FaulknerMassimo/rPod/src/input/wheel_input.c

#include "wheel_input.h"

#include "wheel_tuning.h"
#include "../../daemon/wheel_protocol.h"

#include <errno.h>
#include <stdbool.h>
#include <stdio.h>
#include <stdlib.h>
#include <string.h>
#include <sys/socket.h>
#include <sys/un.h>
#include <unistd.h>

#define POLL_MS       10
#define RETRY_MS      1000

/* --- scroll acceleration (docs/PLAN.md §8.2) -----------------------------
 *
 * Wheel speed is measured over a sliding window of recent wheel events, using
 * the daemon's own timestamps (when the packet came off the wire, not when
 * this poll got to it). Below V0 every STEP_TICKS positions is one step, for
 * precise slow scrolling; between V0 and V1 the multiplier eases in
 * quadratically up to ACCEL_MAX, so a fast flick covers many rows. The
 * numbers are input/wheel_tuning.h's, read on every event so they can be
 * tuned while the wheel turns. */
#define VEL_WINDOW_US       150000u
#define VEL_MIN_SPAN_US     20000u
#define VEL_RING            64

/* --- alphabet scrub (docs/PLAN.md §8.2) -----------------------------------
 *
 * In a long alphabetical list, turning faster than SCRUB_V switches from rows
 * to letters (ui/scrub.h): the list's current letter shows big, and from
 * then on every SCRUB_TICKS positions -- at any speed, so it can be slowed
 * down to land on a letter -- jumps a whole letter. It ends when the finger
 * lifts or the wheel rests for SCRUB_IDLE_MS. SCRUB_V defaults to V1, where
 * the acceleration curve tops out: a list long enough to have letters
 * hands over to them there instead. */
#define SCRUB_IDLE_MS       600u

typedef struct {
    /* Recent wheel events inside the velocity window: ring of (time, |delta|). */
    struct {
        uint64_t ts;
        int ticks;
    } win[VEL_RING];
    int win_head;   /* index of the oldest entry */
    int win_count;
    int win_sum;    /* sum of ticks over the entries in the ring */

    float acc;      /* gain-scaled positions not yet turned into whole steps */
    int last_dir;
    float speed;    /* positions/s as of the last event */
} accel_t;

/* A new gesture (touch down/up, reversal) starts from rest: no leftover
 * fraction of a step, no speed carried over from before. */
static void accel_reset(accel_t *a)
{
    a->win_head = 0;
    a->win_count = 0;
    a->win_sum = 0;
    a->acc = 0.0f;
    a->last_dir = 0;
    a->speed = 0.0f;
}

/* Feeds one wheel delta; returns the whole steps it produced (signed). */
static int accel_feed(accel_t *a, int delta, uint64_t ts)
{
    if (delta == 0) {
        return 0;
    }
    int dir = delta > 0 ? 1 : -1;
    if (a->last_dir != 0 && dir != a->last_dir) {
        accel_reset(a);
    }
    a->last_dir = dir;

    /* Expire events that fell out of the window, then add this one (evicting
     * the oldest if the ring is full -- that only underestimates speed). */
    while (a->win_count > 0 && ts - a->win[a->win_head].ts > VEL_WINDOW_US) {
        a->win_sum -= a->win[a->win_head].ticks;
        a->win_head = (a->win_head + 1) % VEL_RING;
        a->win_count--;
    }
    if (a->win_count == VEL_RING) {
        a->win_sum -= a->win[a->win_head].ticks;
        a->win_head = (a->win_head + 1) % VEL_RING;
        a->win_count--;
    }
    int slot = (a->win_head + a->win_count) % VEL_RING;
    a->win[slot].ts = ts;
    a->win[slot].ticks = abs(delta);
    a->win_count++;
    a->win_sum += abs(delta);

    /* Speed over the span the window actually covers, not the whole window:
     * a flick is often shorter than VEL_WINDOW_US, and dividing by the full
     * window would keep acceleration from engaging until it was nearly over.
     * The oldest event's ticks were travelled before the span began, so they
     * don't count; MIN_SPAN keeps two packets arriving close together from
     * reading as a huge spike. A lone event reads as speed 0. */
    int oldest = a->win_head;
    int newest = (a->win_head + a->win_count - 1) % VEL_RING;
    uint64_t span = a->win[newest].ts - a->win[oldest].ts;
    if (span < VEL_MIN_SPAN_US) {
        span = VEL_MIN_SPAN_US;
    }
    float speed = (float)(a->win_sum - a->win[oldest].ticks) * 1e6f / (float)span;
    a->speed = speed;
    const rpod_wheel_tuning_t *tu = rpod_wheel_tuning();
    float v1 = tu->accel_v1 > tu->accel_v0 ? tu->accel_v1 : tu->accel_v0 + 1.0f;
    float t = (speed - tu->accel_v0) / (v1 - tu->accel_v0);
    t = t < 0.0f ? 0.0f : (t > 1.0f ? 1.0f : t);
    float gain = 1.0f + (tu->accel_max - 1.0f) * t * t;

    a->acc += (float)delta * gain;
    int steps = (int)(a->acc / tu->step_ticks); /* truncates toward zero */
    a->acc -= (float)steps * tu->step_ticks;
    return steps;
}

typedef struct {
    bool active;
    float acc;       /* positions toward the next letter */
    int dir;
    uint32_t last_ms; /* lv_tick_get() of the last wheel event while active */
} scrub_t;

/* --- socket client --------------------------------------------------------- */

typedef struct {
    rpod_input_t *in;
    char path[sizeof(((struct sockaddr_un *)0)->sun_path)];

    int fd;                 /* -1 while disconnected */
    uint32_t retry_at;      /* lv_tick_get() time of the next connect attempt */
    bool logged_waiting;

    /* SOCK_STREAM can split an event across reads; carry partial bytes over. */
    uint8_t rx[sizeof(struct rpod_wheel_event) * 32];
    size_t rx_len;

    accel_t accel;
    scrub_t scrub;
} wheel_input_t;

static void try_connect(wheel_input_t *w)
{
    int fd = socket(AF_UNIX, SOCK_STREAM | SOCK_NONBLOCK | SOCK_CLOEXEC, 0);
    if (fd < 0) {
        return;
    }
    struct sockaddr_un addr;
    memset(&addr, 0, sizeof(addr));
    addr.sun_family = AF_UNIX;
    memcpy(addr.sun_path, w->path, sizeof(addr.sun_path));

    if (connect(fd, (struct sockaddr *)&addr, sizeof(addr)) != 0) {
        close(fd);
        if (!w->logged_waiting) {
            fprintf(stderr, "rpod: waiting for the click wheel daemon at %s\n", w->path);
            w->logged_waiting = true;
        }
        return;
    }
    fprintf(stderr, "rpod: click wheel connected (%s)\n", w->path);
    w->fd = fd;
    w->rx_len = 0;
    w->logged_waiting = false;
}

/* Back to rows, from rest -- the next turn doesn't inherit the scrub's speed. */
static void scrub_end(wheel_input_t *w)
{
    if (w->scrub.active) {
        w->scrub.active = false;
        accel_reset(&w->accel);
    }
}

/* Drops the connection and lets go of anything held, so a daemon restart
 * mid-press can't leave the select button stuck down -- without that
 * synthetic release counting as a click. */
static void disconnect(wheel_input_t *w)
{
    fprintf(stderr, "rpod: click wheel daemon went away; reconnecting\n");
    close(w->fd);
    w->fd = -1;
    w->retry_at = lv_tick_get() + RETRY_MS;
    rpod_input_release_all(w->in);
    scrub_end(w);
    accel_reset(&w->accel);
}

/* One wheel event while scrubbing: a letter per SCRUB_TICKS positions. A
 * reversal starts the count over, so the first letter back isn't early. */
static void scrub_feed(wheel_input_t *w, int delta)
{
    int dir = delta > 0 ? 1 : -1;
    if (dir != w->scrub.dir) {
        w->scrub.dir = dir;
        w->scrub.acc = 0.0f;
    }
    w->scrub.last_ms = lv_tick_get();
    w->scrub.acc += (float)abs(delta);
    float ticks = rpod_wheel_tuning()->scrub_ticks;
    while (w->scrub.acc >= ticks) {
        w->scrub.acc -= ticks;
        if (!rpod_input_scrub(w->in, dir)) {
            scrub_end(w); /* the screen changed under it */
            return;
        }
    }
}

static void handle_wheel(wheel_input_t *w, const struct rpod_wheel_event *ev)
{
    if (rpod_input_fine()) {
        rpod_input_rotate(w->in, ev->value); /* a game steering: position for position */
        return;
    }
    if (w->scrub.active) {
        scrub_feed(w, ev->value);
        return;
    }
    int steps = accel_feed(&w->accel, ev->value, ev->timestamp_us);
    if (w->accel.speed >= rpod_wheel_tuning_scrub_v() && rpod_input_scrub(w->in, 0)) {
        w->scrub.active = true;
        w->scrub.dir = 0;
        w->scrub.last_ms = lv_tick_get();
        return; /* this turn just brings up the letter */
    }
    rpod_input_rotate(w->in, steps);
}

static void handle_event(wheel_input_t *w, const struct rpod_wheel_event *ev)
{
    static const rpod_button_t k_buttons[] = {
        [RPOD_WHEEL_BTN_CENTER] = RPOD_BTN_CENTER,
        [RPOD_WHEEL_BTN_UP]     = RPOD_BTN_MENU,
        [RPOD_WHEEL_BTN_DOWN]   = RPOD_BTN_PLAY_PAUSE,
        [RPOD_WHEEL_BTN_LEFT]   = RPOD_BTN_PREV,
        [RPOD_WHEEL_BTN_RIGHT]  = RPOD_BTN_NEXT,
    };

    switch (ev->type) {
    case RPOD_WHEEL_EVENT_WHEEL:
        handle_wheel(w, ev);
        break;

    case RPOD_WHEEL_EVENT_TOUCH:
        if (ev->value == 0) {
            scrub_end(w);
        } else {
            rpod_input_touch(w->in);
        }
        accel_reset(&w->accel);
        break;

    case RPOD_WHEEL_EVENT_BUTTON:
        if (ev->code >= sizeof(k_buttons) / sizeof(k_buttons[0])) {
            break;
        }
        if (ev->value != 0) {
            scrub_end(w);
        }
        /* Fed per edge, not once per poll: a tap whose press and release
         * land in the same poll must still register. */
        rpod_input_button(w->in, k_buttons[ev->code], ev->value != 0);
        break;

    default:
        break;
    }
}

static void poll_cb(lv_timer_t *timer)
{
    wheel_input_t *w = lv_timer_get_user_data(timer);

    if (w->fd < 0) {
        if ((int32_t)(lv_tick_get() - w->retry_at) < 0) {
            return;
        }
        try_connect(w);
        if (w->fd < 0) {
            w->retry_at = lv_tick_get() + RETRY_MS;
            return;
        }
    }

    bool got_any = false;
    for (;;) {
        ssize_t n = recv(w->fd, w->rx + w->rx_len, sizeof(w->rx) - w->rx_len, MSG_DONTWAIT);
        if (n < 0 && (errno == EAGAIN || errno == EWOULDBLOCK)) {
            break;
        }
        if (n < 0 && errno == EINTR) {
            continue;
        }
        if (n <= 0) {
            disconnect(w);
            break;
        }
        w->rx_len += (size_t)n;

        size_t off = 0;
        while (w->rx_len - off >= sizeof(struct rpod_wheel_event)) {
            struct rpod_wheel_event ev;
            memcpy(&ev, w->rx + off, sizeof(ev));
            off += sizeof(ev);
            handle_event(w, &ev);
            got_any = true;
        }
        memmove(w->rx, w->rx + off, w->rx_len - off);
        w->rx_len -= off;
    }

    if (w->scrub.active && lv_tick_elaps(w->scrub.last_ms) > SCRUB_IDLE_MS) {
        scrub_end(w);
    }

    /* Hand it to LVGL now rather than waiting up to a whole read period for
     * the indev's own timer -- a button should feel instant. */
    if (got_any) {
        lv_indev_read(rpod_input_indev(w->in));
    }
}

void rpod_wheel_input_create(const char *sock_path, rpod_input_t *in)
{
    wheel_input_t *w = calloc(1, sizeof(*w));
    w->in = in;
    snprintf(w->path, sizeof(w->path), "%s", sock_path != NULL ? sock_path : RPOD_WHEEL_SOCK_PATH);
    w->fd = -1;
    w->retry_at = lv_tick_get();

    const rpod_wheel_tuning_t *tu = rpod_wheel_tuning();
    fprintf(stderr, "rpod: wheel accel: %.1f positions/step, x%.1f max between %.0f and %.0f positions/s\n",
            (double)tu->step_ticks, (double)tu->accel_max, (double)tu->accel_v0, (double)tu->accel_v1);
    fprintf(stderr, "rpod: wheel scrub: letters above %.0f positions/s, %.1f positions/letter\n",
            (double)rpod_wheel_tuning_scrub_v(), (double)tu->scrub_ticks);

    lv_timer_create(poll_cb, POLL_MS, w);
}
