FaulknerMassimo/rPod/src/ui/screens/music_screens.c

#include "music_screens.h"

#include "list_screen.h"
#include "now_playing.h"
#include "search_screen.h"
#include "playlist_edit_screens.h"
#include "playlist_picker.h"
#include "audio/mpd_client.h"
#include "ui/alpha_sort.h"
#include "ui/classic.h"
#include "ui/cover_cache.h"
#include "ui/heart_icon.h"
#include "ui/metrics.h"
#include "ui/playlist_membership.h"
#include "ui/scrub.h"
#include "ui/theme.h"

#include <stdint.h>
#include <stdio.h>
#include <stdlib.h>
#include <string.h>

/* Per-screen filter, passed as the rpod_screen_stack_push() ctx for every
 * browse/leaf screen below. Which fields are meaningful depends on the
 * screen: album/artist lists use `artist`; the song list uses whichever of
 * `artist`+`album` or `playlist` got set on the way down. */
typedef struct {
    rpod_mpd_t *mpd;
    char *artist;
    char *album;
    char *genre;
    char *playlist;
} music_ctx_t;

static char *dup_or_null(const char *s)
{
    return s != NULL ? strdup(s) : NULL;
}

static music_ctx_t *music_ctx_new(rpod_mpd_t *mpd, const char *artist, const char *album,
                                   const char *genre, const char *playlist)
{
    music_ctx_t *ctx = calloc(1, sizeof(*ctx));
    ctx->mpd = mpd;
    ctx->artist = dup_or_null(artist);
    ctx->album = dup_or_null(album);
    ctx->genre = dup_or_null(genre);
    ctx->playlist = dup_or_null(playlist);
    return ctx;
}

static void music_ctx_free(void *p)
{
    music_ctx_t *ctx = p;
    free(ctx->artist);
    free(ctx->album);
    free(ctx->genre);
    free(ctx->playlist);
    free(ctx);
}

/* A clicked row's context for the name-only browse screens (artists,
 * albums, genres, playlists): which connection, which name, and -- for
 * albums reached via an artist -- which artist scoped the list, so
 * selecting an album can carry the artist filter forward to the song list. */
typedef struct {
    rpod_mpd_t *mpd;
    const char *name;
    const char *parent_artist;
} name_row_t;

/* Owns the raw mpd_item_t array a browse screen fetched plus the name_row_t
 * array built from it, both freed together when the screen is popped. */
typedef struct {
    rpod_mpd_item_t *items_raw;
    name_row_t *rows;
} name_list_fetch_t;

static void name_list_cleanup_cb(lv_event_t *e)
{
    name_list_fetch_t *fetch = lv_event_get_user_data(e);
    rpod_mpd_free_items(fetch->items_raw);
    free(fetch->rows);
    free(fetch);
}

static int item_alpha_cmp(const void *a, const void *b)
{
    return rpod_alpha_compare(((const rpod_mpd_item_t *)a)->name, ((const rpod_mpd_item_t *)b)->name);
}

/* Shared plumbing for every name-only browse screen: takes ownership of
 * `items_raw` (already fetched by the caller), builds the on-screen list,
 * and wires each row's item_ctx to a name_row_t carrying `parent_artist`
 * through (NULL where it doesn't apply).
 *
 * Rows go in iPod order (ui/alpha_sort.h) rather than MPD's: its `list` is a
 * plain byte sort, which puts lowercase names after every capitalised one
 * and accented ones after Z -- and the alphabet scrub needs each letter's
 * rows together. */
static void build_name_list_screen(rpod_screen_stack_t *stack, lv_obj_t *screen,
                                    rpod_mpd_t *mpd, rpod_mpd_item_t *items_raw, size_t count,
                                    const char *parent_artist,
                                    void (*on_select)(rpod_screen_stack_t *, void *))
{
    if (count > 1) {
        qsort(items_raw, count, sizeof(*items_raw), item_alpha_cmp);
    }

    name_list_fetch_t *fetch = malloc(sizeof(*fetch));
    fetch->items_raw = items_raw;
    fetch->rows = count > 0 ? malloc(count * sizeof(*fetch->rows)) : NULL;
    for (size_t i = 0; i < count; i++) {
        fetch->rows[i].mpd = mpd;
        fetch->rows[i].name = items_raw[i].name;
        fetch->rows[i].parent_artist = parent_artist;
    }
    lv_obj_add_event_cb(screen, name_list_cleanup_cb, LV_EVENT_DELETE, fetch);

    rpod_list_item_t *ui_items = count > 0 ? calloc(count, sizeof(*ui_items)) : NULL;
    for (size_t i = 0; i < count; i++) {
        snprintf(ui_items[i].text, sizeof(ui_items[i].text), "%s", items_raw[i].name);
        ui_items[i].chevron = true;
        ui_items[i].on_select = on_select;
        ui_items[i].item_ctx = &fetch->rows[i];
    }
    lv_obj_t *list = rpod_list_screen_build(stack, screen, ui_items, count);
    rpod_list_screen_enable_scrub(screen, list);
    free(ui_items);
}

static void build_song_list_screen(rpod_screen_stack_t *stack, lv_obj_t *screen, void *ctx);
static void build_album_list_screen(rpod_screen_stack_t *stack, lv_obj_t *screen, void *ctx);
static void build_genre_artist_list_screen(rpod_screen_stack_t *stack, lv_obj_t *screen, void *ctx);
static rpod_row_status_t status_for_uri(const rpod_playlist_index_t *idx, const char *uri);

static void on_album_select(rpod_screen_stack_t *stack, void *item_ctx)
{
    name_row_t *row = item_ctx;
    rpod_screen_stack_push(stack, build_song_list_screen,
                            music_ctx_new(row->mpd, row->parent_artist, row->name, NULL, NULL),
                            music_ctx_free);
}

static void on_artist_select(rpod_screen_stack_t *stack, void *item_ctx)
{
    name_row_t *row = item_ctx;
    rpod_screen_stack_push(stack, build_album_list_screen,
                            music_ctx_new(row->mpd, row->name, NULL, NULL, NULL),
                            music_ctx_free);
}

static void on_genre_select(rpod_screen_stack_t *stack, void *item_ctx)
{
    name_row_t *row = item_ctx;
    rpod_screen_stack_push(stack, build_genre_artist_list_screen,
                            music_ctx_new(row->mpd, NULL, NULL, row->name, NULL), music_ctx_free);
}

static void on_playlist_select(rpod_screen_stack_t *stack, void *item_ctx)
{
    name_row_t *row = item_ctx;
    rpod_screen_stack_push(stack, build_song_list_screen,
                            music_ctx_new(row->mpd, NULL, NULL, NULL, row->name), music_ctx_free);
}

static void build_album_list_screen(rpod_screen_stack_t *stack, lv_obj_t *screen, void *ctx)
{
    music_ctx_t *filter = ctx;
    if (filter->artist != NULL) {
        rpod_screen_stack_set_title(stack, filter->artist);
    }
    rpod_mpd_item_t *items = NULL;
    size_t count = 0;
    rpod_mpd_list_albums(filter->mpd, filter->artist, &items, &count);
    build_name_list_screen(stack, screen, filter->mpd, items, count, filter->artist, on_album_select);
}

static void build_artist_list_screen(rpod_screen_stack_t *stack, lv_obj_t *screen, void *ctx)
{
    music_ctx_t *filter = ctx;
    rpod_mpd_item_t *items = NULL;
    size_t count = 0;
    rpod_mpd_list_artists(filter->mpd, &items, &count);
    build_name_list_screen(stack, screen, filter->mpd, items, count, NULL, on_artist_select);
}

static void build_genre_artist_list_screen(rpod_screen_stack_t *stack, lv_obj_t *screen, void *ctx)
{
    music_ctx_t *filter = ctx;
    rpod_screen_stack_set_title(stack, filter->genre);
    rpod_mpd_item_t *items = NULL;
    size_t count = 0;
    rpod_mpd_list_artists_in_genre(filter->mpd, filter->genre, &items, &count);
    /* Same next screen as the plain Artists list: pick an artist, browse
     * their albums -- the genre filter has done its job by here. */
    build_name_list_screen(stack, screen, filter->mpd, items, count, NULL, on_artist_select);
}

static void build_genre_list_screen(rpod_screen_stack_t *stack, lv_obj_t *screen, void *ctx)
{
    music_ctx_t *filter = ctx;
    rpod_mpd_item_t *items = NULL;
    size_t count = 0;
    rpod_mpd_list_genres(filter->mpd, &items, &count);
    build_name_list_screen(stack, screen, filter->mpd, items, count, NULL, on_genre_select);
}

static void on_new_playlist(rpod_screen_stack_t *stack, void *item_ctx)
{
    rpod_screen_stack_push(stack, rpod_new_playlist_name_build, item_ctx, NULL);
}

/* Not routed through build_name_list_screen -- that helper assumes a 1:1
 * mapping between fetched items and rows, but this list also needs one
 * extra leading action row ("New Playlist") that isn't an MPD playlist at
 * all.
 *
 * Rebuilds (rather than being built once): a brand new playlist only
 * starts existing server-side once its first song is added, from the Add
 * Songs picker pushed on top of this screen -- so this screen's own rows,
 * fetched back when it was first pushed, would otherwise go stale the
 * moment the user backs out and never show the playlist they just made.
 * Called directly for the initial build and again from
 * playlist_list_loaded_cb on every LV_EVENT_SCREEN_LOADED (i.e. every time
 * this screen becomes visible again, including via pop -- see
 * screen_stack.c's pop() for why group-default ordering makes it safe for
 * a LOADED handler to create fresh focusable rows here). */
static void populate_playlist_list(rpod_screen_stack_t *stack, lv_obj_t *screen, rpod_mpd_t *mpd)
{
    lv_obj_t *old_list = lv_obj_get_child(screen, 0);
    if (old_list != NULL) {
        lv_obj_delete(old_list);
    }

    rpod_mpd_item_t *items = NULL;
    size_t count = 0;
    rpod_mpd_list_playlists(mpd, &items, &count);

    name_list_fetch_t *fetch = malloc(sizeof(*fetch));
    fetch->items_raw = items;
    /* One extra row slot for the pinned "Liked Songs" entry (row index
     * `count`), whose name is a stable string literal rather than an
     * items_raw[] pointer. */
    fetch->rows = malloc((count + 1) * sizeof(*fetch->rows));
    for (size_t i = 0; i < count; i++) {
        fetch->rows[i].mpd = mpd;
        fetch->rows[i].name = items[i].name;
        fetch->rows[i].parent_artist = NULL;
    }
    fetch->rows[count].mpd = mpd;
    fetch->rows[count].name = RPOD_LIKED_PLAYLIST_NAME;
    fetch->rows[count].parent_artist = NULL;

    /* Leading rows: "New Playlist", then "Liked Songs" pinned above the rest
     * (shown even before it exists server-side). A real "Liked Songs" among
     * the fetched playlists is skipped below so it isn't listed twice. */
    rpod_list_item_t *ui_items = calloc(count + 2, sizeof(*ui_items));
    size_t ui = 0;
    snprintf(ui_items[ui].text, sizeof(ui_items[ui].text), "New Playlist");
    ui_items[ui].chevron = true;
    ui_items[ui].on_select = on_new_playlist;
    ui_items[ui].item_ctx = mpd;
    ui++;
    snprintf(ui_items[ui].text, sizeof(ui_items[ui].text), "%s", RPOD_LIKED_PLAYLIST_NAME);
    ui_items[ui].chevron = true;
    ui_items[ui].on_select = on_playlist_select;
    ui_items[ui].item_ctx = &fetch->rows[count];
    ui++;
    for (size_t i = 0; i < count; i++) {
        if (strcmp(items[i].name, RPOD_LIKED_PLAYLIST_NAME) == 0) {
            continue;
        }
        snprintf(ui_items[ui].text, sizeof(ui_items[ui].text), "%s", items[i].name);
        ui_items[ui].chevron = true;
        ui_items[ui].on_select = on_playlist_select;
        ui_items[ui].item_ctx = &fetch->rows[i];
        ui++;
    }
    rpod_list_screen_build(stack, screen, ui_items, ui);
    free(ui_items);

    /* Attached to the freshly created list itself, not the screen -- so
     * the lv_obj_delete(old_list) above on the *next* refresh frees this
     * exact fetch at the right time instead of leaking it until the whole
     * screen is torn down. */
    lv_obj_t *list = lv_obj_get_child(screen, 0);
    lv_obj_add_event_cb(list, name_list_cleanup_cb, LV_EVENT_DELETE, fetch);
}

typedef struct {
    rpod_screen_stack_t *stack;
    rpod_mpd_t *mpd;
} playlists_screen_ctx_t;

static void playlists_screen_ctx_free_cb(lv_event_t *e)
{
    free(lv_event_get_user_data(e));
}

static void playlist_list_loaded_cb(lv_event_t *e)
{
    playlists_screen_ctx_t *pc = lv_event_get_user_data(e);
    populate_playlist_list(pc->stack, lv_event_get_target(e), pc->mpd);
}

static void build_playlist_list_screen(rpod_screen_stack_t *stack, lv_obj_t *screen, void *ctx)
{
    music_ctx_t *filter = ctx;

    playlists_screen_ctx_t *pc = malloc(sizeof(*pc));
    pc->stack = stack;
    pc->mpd = filter->mpd;
    lv_obj_add_event_cb(screen, playlist_list_loaded_cb, LV_EVENT_SCREEN_LOADED, pc);
    lv_obj_add_event_cb(screen, playlists_screen_ctx_free_cb, LV_EVENT_DELETE, pc);
}

/* A clicked song row's context: the connection, plus the whole fetched song
 * collection this row belongs to (owned by the fetch) and this row's index
 * within it. Selecting a row queues the entire collection and starts at
 * `index`, so playback carries on through the album/playlist rather than
 * stopping after the one tapped track. */
typedef struct {
    rpod_mpd_t *mpd;
    const rpod_mpd_song_t *songs;
    size_t count;
    size_t index;
} song_row_t;

typedef struct {
    rpod_mpd_t *mpd;
    rpod_screen_stack_t *stack;
    rpod_mpd_song_t *songs;
    size_t count;
    song_row_t *rows;
    bool show_art; /* rows carry a cover column (see build_song_list_screen) */
    /* The collection header's cover tile (build_collection_header() below)
     * and the songs whose album covers it shows: one for a single album, up
     * to four distinct albums as a 2x2 mosaic for a playlist. Covers decode in
     * the background (ui/cover_cache.h); refresh_header_cover() fills the tile
     * once they've all resolved. header_tile is NULL for lists with no header
     * (artist song lists). */
    lv_obj_t *header_tile;
    size_t header_cover_songs[4];
    size_t header_cover_count;
    bool header_filled;

    /* Liked/playlist indicators. The index is (re)built and the rows'
     * trailing marks refreshed whenever the screen regains focus (see
     * song_list_loaded_cb), so a like made on Now Playing or an edit made in
     * the Add-to-Playlist picker shows on return. `list`, `lead`, and
     * `header_present` locate the song rows among the list's children. */
    rpod_playlist_index_t *index;
    lv_obj_t *list;
    size_t lead;
    bool header_present;
} song_list_fetch_t;

static void song_list_cleanup_cb(lv_event_t *e)
{
    song_list_fetch_t *fetch = lv_event_get_user_data(e);
    rpod_playlist_index_free(fetch->index);
    rpod_mpd_free_songs(fetch->songs);
    free(fetch->rows);
    free(fetch);
}

/* On (re)gaining focus: refresh the playlist index and every song row's mark.
 * Built here rather than at build time so the first focus and every return
 * share one path -- see the same pattern in build_playlist_list_screen. */
static void song_list_loaded_cb(lv_event_t *e)
{
    song_list_fetch_t *fetch = lv_event_get_user_data(e);
    if (fetch->index == NULL) {
        fetch->index = rpod_playlist_index_build(fetch->mpd);
    } else {
        rpod_playlist_index_rebuild(fetch->index, fetch->mpd);
    }

    size_t base = (fetch->header_present ? 1 : 0) + fetch->lead;
    for (size_t j = 0; j < fetch->count; j++) {
        lv_obj_t *btn = lv_obj_get_child(fetch->list, (int32_t)(base + j));
        if (btn == NULL) {
            break;
        }
        rpod_list_row_set_status(btn, status_for_uri(fetch->index, fetch->songs[j].uri));
    }
}

static void on_song_select(rpod_screen_stack_t *stack, void *item_ctx)
{
    song_row_t *row = item_ctx;
    rpod_mpd_play_songs_from(row->mpd, row->songs, row->count, row->index);
    rpod_screen_stack_push(stack, rpod_now_playing_build, row->mpd, NULL);
}

/* Press-and-hold a song row: open the Add-to-Playlist picker for it. */
static void on_song_long_press(rpod_screen_stack_t *stack, void *item_ctx)
{
    song_row_t *row = item_ctx;
    const rpod_mpd_song_t *s = &row->songs[row->index];
    rpod_playlist_picker_push(stack, row->mpd, s->uri, s->title);
}

/* Heart for a liked song, checkmark for one in some other playlist, else
 * nothing -- the heart wins when a song is both liked and in a playlist. */
static rpod_row_status_t status_for_uri(const rpod_playlist_index_t *idx, const char *uri)
{
    if (rpod_playlist_index_is_liked(idx, uri)) {
        return RPOD_ROW_STATUS_HEART;
    }
    if (rpod_playlist_index_in_other(idx, uri)) {
        return RPOD_ROW_STATUS_CHECK;
    }
    return RPOD_ROW_STATUS_NONE;
}

static void on_add_songs_to_playlist(rpod_screen_stack_t *stack, void *item_ctx)
{
    music_ctx_t *filter = item_ctx;
    rpod_push_add_songs_screen(stack, filter->mpd, filter->playlist);
}

/* Square size (px) the collection header's cover tile renders at -- bigger
 * than a row thumbnail (rpod_metrics()->list_art_size), smaller than Now
 * Playing's ART_SIZE, since it shares the screen with the title/subtitle, the
 * Play/Shuffle row, and the rows below -- all of which need to fit inside
 * the list's own viewport height (screen_h - header_h - 16, see
 * rpod_list_screen_create()) for Play/Shuffle to be visible without scrolling
 * on first load. A playlist's 2x2 mosaic splits this tile into four
 * RPOD_HEADER_ART_SIZE/2 quadrants. */
#define RPOD_HEADER_ART_SIZE 72

static void on_play_collection_clicked(lv_event_t *e)
{
    song_list_fetch_t *fetch = lv_event_get_user_data(e);
    if (fetch->count == 0) {
        return;
    }
    rpod_mpd_play_songs(fetch->mpd, fetch->songs, fetch->count);
    rpod_screen_stack_push(fetch->stack, rpod_now_playing_build, fetch->mpd, NULL);
}

static void on_shuffle_collection_clicked(lv_event_t *e)
{
    song_list_fetch_t *fetch = lv_event_get_user_data(e);
    if (fetch->count == 0) {
        return;
    }
    rpod_mpd_play_songs_shuffled(fetch->mpd, fetch->songs, fetch->count);
    rpod_screen_stack_push(fetch->stack, rpod_now_playing_build, fetch->mpd, NULL);
}

/* Play/Shuffle sit at the *bottom* of the header, below the cover and
 * title/subtitle -- LVGL's own scroll-on-focus (or row_focus_cb's pattern for
 * plain rows) only scrolls far enough to reveal the focused object itself,
 * so re-focusing Play/Shuffle after scrolling down into the song list would
 * otherwise leave just the button row in view with the cover scrolled past
 * the top edge. Scroll the whole header (btn's grandparent: btn -> btn_row
 * -> header) into view instead, so the cover comes back with it. */
static void collection_header_button_focused_cb(lv_event_t *e)
{
    lv_obj_t *btn = lv_event_get_target(e);
    /* Classic's rows are the header's own children; scrolling to the row
     * itself is all they need. */
    if (rpod_theme()->classic) {
        lv_obj_scroll_to_view_recursive(btn, LV_ANIM_OFF);
        return;
    }
    lv_obj_t *header = lv_obj_get_parent(lv_obj_get_parent(btn));
    lv_obj_scroll_to_view_recursive(header, LV_ANIM_OFF);
}

static lv_obj_t *build_collection_action_button(lv_obj_t *parent, const char *label,
                                                lv_event_cb_t on_click, song_list_fetch_t *fetch)
{
    lv_obj_t *btn = lv_button_create(parent);
    lv_obj_remove_style_all(btn);
    /* See row_focus_cb in list_screen.c: LVGL's default eased scroll-on-focus
     * reads as laggy against a click wheel, and here it would also fight
     * with collection_header_button_focused_cb's own scroll target. */
    lv_obj_remove_flag(btn, LV_OBJ_FLAG_SCROLL_ON_FOCUS);
    const rpod_metrics_t *m = rpod_metrics();
    lv_obj_set_size(btn, (m->screen_w - 16 - 2 * 14 - 12) / 2, 36);
    lv_obj_set_style_radius(btn, 8, 0);
    lv_obj_set_style_bg_color(btn, RPOD_COLOR_GLASS_FILL, LV_STATE_DEFAULT);
    lv_obj_set_style_bg_opa(btn, LV_OPA_COVER, LV_STATE_DEFAULT);
    lv_obj_set_style_bg_color(btn, RPOD_COLOR_ACCENT, LV_STATE_FOCUSED);
    lv_obj_set_style_bg_opa(btn, LV_OPA_COVER, LV_STATE_FOCUSED);

    lv_obj_t *lbl = lv_label_create(btn);
    lv_label_set_text(lbl, label);
    lv_obj_set_style_text_color(lbl, RPOD_COLOR_TEXT, 0);
    lv_obj_center(lbl);

    lv_obj_add_event_cb(btn, on_click, LV_EVENT_CLICKED, fetch);
    lv_obj_add_event_cb(btn, collection_header_button_focused_cb, LV_EVENT_FOCUSED, NULL);
    return btn;
}

/* Fills the header's cover tile once every requested cover has resolved:
 * a single cover fills the whole tile (a plain album), two-to-four lay out
 * as a 2x2 mosaic (a playlist collage), each cover one quadrant. Fewer than
 * four decoded covers cycle to fill all four quadrants -- a half-blank
 * mosaic reads as broken, a repeated tile reads as intentional. Nothing
 * decodable keeps the audio-symbol placeholder, same as a row with no art.
 * Waits for all of them rather than drawing progressively, so a mosaic
 * doesn't visibly reshuffle as each cover lands. Each cover is requested at
 * its on-screen size (full tile vs. quadrant), per list_screen.h's note
 * against leaning on lv_image to rescale. Called at build time (covers may
 * already be cached) and again as background decodes finish. */
static void refresh_header_cover(song_list_fetch_t *fetch)
{
    if (fetch->header_tile == NULL || fetch->header_filled) {
        return;
    }
    bool mosaic = fetch->header_cover_count > 1;
    int cell = mosaic ? RPOD_HEADER_ART_SIZE / 2 : RPOD_HEADER_ART_SIZE;

    const lv_image_dsc_t *ready[4];
    size_t k = 0;
    for (size_t i = 0; i < fetch->header_cover_count; i++) {
        const rpod_mpd_song_t *s = &fetch->songs[fetch->header_cover_songs[i]];
        bool pending = false;
        const lv_image_dsc_t *dsc = rpod_cover_cache_get(s->album_artist, s->album, s->uri, cell, &pending);
        if (pending) {
            return;
        }
        if (dsc != NULL) {
            ready[k++] = dsc;
        }
    }
    fetch->header_filled = true;
    if (k == 0) {
        return;
    }

    lv_obj_t *tile = fetch->header_tile;
    lv_obj_clean(tile);
    if (!mosaic) {
        lv_obj_t *img = lv_image_create(tile);
        lv_image_set_src(img, ready[0]);
        lv_obj_set_size(img, RPOD_HEADER_ART_SIZE, RPOD_HEADER_ART_SIZE);
        lv_obj_center(img);
    } else {
        for (int q = 0; q < 4; q++) {
            lv_obj_t *img = lv_image_create(tile);
            lv_image_set_src(img, ready[q % (int)k]);
            lv_obj_set_size(img, cell, cell);
            lv_obj_set_pos(img, (q % 2) * cell, (q / 2) * cell);
        }
    }
}
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
