FaulknerMassimo/rPod/(commit log)

2026-07-20 Scaffold Phase 0: repo layout, sim harness, cross-build, wheel sniffer
    Sets up the structure from docs/PLAN.md: LVGL v9.5.0 vendored as a submodule,
    a desktop SDL simulator for UI iteration without hardware, a cross-compiled
    hello-world entry point, systemd units, boot config fragments, and
    tools/wheel-sniff.c to derive the real click-wheel bit map on real hardware
    before any parsing code is written.
2026-07-20 Phase 1: LVGL on the fbtft framebuffer
    Adds src/ui/lvgl_port.c to bind LVGL to /dev/fb1 via the Linux fbdev
    driver, and a device-side lv_conf.h configured per docs/PLAN.md §5.3
    (partial rendering, two 40-line draw buffers). main.c now renders the
    same "rPod" label + spinner scene as the desktop simulator instead of
    the Phase 0 hello-world stub, so both are directly comparable.
    tools/fb-test.c is a dependency-free raw-framebuffer colour-fill tool
    for the §5.2/§9 bring-up step (confirm orientation/offsets/colour
    order) independently of LVGL, isolating panel wiring bugs from UI
    bugs. Both sim and device lv_conf.h now enable the on-screen perf
    monitor so fps is visible for the Phase 1 accept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
    [fb-test.c, lvgl_port.c, lvgl_port.h, main.c]
2026-07-20 Phase 2: click wheel decoder daemon and test client
    Adds daemon/rpod-wheel.c: a privileged root process that decodes the
    4th-gen click wheel's synchronous serial stream (docs/PLAN.md §4.2,
    same framing algorithm as tools/wheel-sniff.c) and publishes edge-
    triggered button events, wrap-corrected wheel deltas, and touch state
    over a Unix socket at /run/rpod/wheel.sock. Handles the hold switch
    (suppress emission, keep decoding) and haptics (runtime-tunable pulse
    divisor via SIGHUP + /etc/rpod/wheel.conf).
    The wire struct and socket path live in daemon/wheel_protocol.h, which
    has no hardware dependency and builds immediately. The actual field
    bit positions live in daemon/wheel_bits.h, split ou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
    [rpod-wheel.c, wheel-test-client.c, wheel_bits.h, wheel_protocol.h]
2026-07-20 Add docs/wiring.md with physical header pin numbers
    docs/PLAN.md §1.2 only lists BCM GPIO numbers, which isn't enough to
    place a wire on the 40-pin header. Adds the physical pin for every
    signal, plus a callout for the GPIO 25 collision between the display's
    D/C line (Waveshare's default wiring) and the click wheel's DATA line
    (fixed to match the sPot reference schematic) — the project already
    wires around it via dc_pin=24 in system/config.txt.d/rpod.txt, but
    it's an easy trap to fall into wiring from the panel's own docs.
2026-07-20 Phase 1: fix landscape orientation and two hardware-verified display bugs
    Corrects docs/PLAN.md's screen orientation: click-wheel iPods (4th gen,
    Photo, Video/Classic, Mini) had landscape screens above the wheel, despite
    the device body being portrait overall. §5/§8 and the fbtft overlay
    (rotate=90 added, dc_pin unaffected) now reflect that; sim and device
    configs both switch to 320x240.
    Two real bugs found and fixed by testing on actual hardware:
    - LV_MEM_SIZE (64K) was too tight for the wider landscape draw buffers,
    and LV_USE_ASSERT_MALLOC's handler turns a failed allocation into a
    silent infinite-loop hang: 100% CPU, no crash, no log output, screen
    just never updates. Bumped to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
2026-07-20 Fix pigpio init failure on vc4-kms-v3d (initMboxBlock: mbox zaps failed)
    gpioInitialise() failed outright on real hardware with dtoverlay=vc4-kms-v3d
    active (system/config.txt.d/rpod.txt) — the DRM/KMS driver holds the legacy
    GPU memory pool that pigpio's default mailbox-based DMA allocation needs,
    independent of gpu_mem=. Calling gpioCfgMemAlloc(PI_MEM_ALLOC_PAGEMAP)
    before gpioInitialise() sidesteps the mailbox path entirely and fixes it.
    Confirmed on hardware in both tools/wheel-sniff.c and daemon/rpod-wheel.c.
    Also notes in docs/PLAN.md that pigpio isn't packaged for this OS (only
    the pigpiod_if2 daemon-client split is available via apt) — build the
    classic library from source direc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
    [rpod-wheel.c, wheel-sniff.c]
2026-07-21 UI: full screen graph in the simulator, backed by real local MPD
    The click wheel is dead and the DAC isn't wired up, so this pulls forward
    the UI-integration parts of Phase 4 that don't depend on either: the full
    Main Menu / Music browse+playback / Now Playing / Settings / Extras screen
    graph (src/ui/screens/), a libmpdclient wrapper (src/audio/mpd_client.c),
    and a keyboard-as-wheel stand-in for the simulator (tools/sim/sim_input.c).
    Also fixes four bugs found by testing against a real MPD instance and a
    real 552-track library rather than mocked data: libmpdclient's searchadd
    side effect enqueuing tracks just from browsing, a connection error that
    wasn't being cleared and silently broke eve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
    [list_screen.c, list_screen.h, main_menu.c, main_menu.h, music_screens.c, music_screens.h]
2026-07-21 UI: iOS-style Now Playing screen with real cover art
    Redesigns Now Playing with a rounded cover-art tile, title/artist/album
    typographic hierarchy, and a thin scrubber with elapsed/remaining time --
    no transport buttons, since the click wheel already drives playback
    globally regardless of which screen is on top.
    Cover art is fetched via MPD's readpicture/albumart and decoded with a
    memory-conscious pipeline built for this project's 512 MB budget: JPEG
    via TJpgDec, point-sampled straight down to thumbnail size as MCU blocks
    stream in so the full-resolution image is never materialized; PNG via a
    small decoder of our own against system zlib, since this project's
    vendored lodepng.c is an LVGL f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
    [cover_art.c, cover_art.h, now_playing.c]
2026-07-21 UI: iOS-style menu rows with song metadata
    List rows now render as an iOS-style inset card list: dark elevated row
    background, separators between rows, optional dim subtitle line, optional
    right-aligned accessory text, and an optional ">" chevron for rows that
    push another screen. Song rows show "Artist - Album" plus duration;
    Audio Output rows show On/Off as an accessory instead of jammed into the
    title.
    Fixes along the way, found via a headless lv_snapshot_take() render
    rather than the real app:
    - Row titles were invisible against the new dark row background because
    the light-mode theme's default text color was never overridden.
    - Long titles/subtitles wrapped instead of truncating -- L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
    [list_screen.c, list_screen.h, main_menu.c, music_screens.c, settings_screens.c, theme.h]
2026-07-21 UI: liquid glass styling and an audio-reactive Now Playing visualizer
    Applies a translucent "glass" material (theme.c/h:
    rpod_theme_style_glass_bar()/glass_panel()) to headers and list cards
    throughout, and to Now Playing's cover art tile, track info, and scrubber
    panel. No live backdrop blur -- LVGL's software renderer has no such
    primitive, and PLAN.md's partial-render budget rules out full-frame work
    per frame -- so Now Playing's backdrop is instead a one-time blur
    (rpod_cover_art_decode_background()) computed on track change: cover art
    decoded tiny and upscaled (the downsample does most of the softening),
    box-blurred, then darkened for legibility.
    Adds a real audio-reactive spectrum vis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
2026-07-21 Fix accented characters rendering as blank boxes
    LVGL's bundled Montserrat fonts only cover ASCII 0x20-0x7F plus a couple
    of symbols, so any accented Latin character in song metadata (e.g.
    "Beyoncé", "Mötley Crüe") fell back to the missing-glyph placeholder box.
    Regenerate the 4 sizes we use (14/16/20/24) with Latin-1 Supplement and
    Latin Extended-A added, kept as project-owned files in src/ui/fonts/ so
    the vendored LVGL submodule stays untouched, wired in under the same
    symbol names via LV_FONT_CUSTOM_DECLARE.
2026-07-21 UI: persistent top status bar with clock, battery, and Now Playing
    Replaces the old per-screen title header with one bar living on LVGL's
    system layer (created once, drawn above every screen the stack pushes):
    time on the left, "rPod" or the current track's title + a live audio
    visualizer in the centre, and a battery indicator on the right. Battery
    is a fixed "--%" for now -- no fuel-gauge hardware is wired up yet.
    Title/visualizer show whenever MPD has a current track (playing, paused,
    or stopped-with-a-loaded-song), matching the same condition main_menu.c
    already uses for its own "Now Playing" row.
    Now Playing's own visualizer now reuses the status bar's shared FIFO
    reader instead of sta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
    [list_screen.c, list_screen.h, main_menu.c, music_screens.c, now_playing.c, settings_screens.c, status_bar.c]
2026-07-22 UI: create playlists and add songs from Music > Playlists
    Adds a "New Playlist" row (on-screen-keyboard naming, same input model
    as Search) and an "Add Songs..." picker reachable from it or from any
    existing playlist's song list -- selecting a song there appends it via
    MPD's playlistadd (rpod_mpd_playlist_add_song) instead of playing it.
    Also fixes the Playlists screen going stale after returning from that
    flow: it now refreshes on LV_EVENT_SCREEN_LOADED instead of only
    fetching once at push time, which required reordering screen_stack.c's
    pop() to set group state before the screen load fires that event.
    [music_screens.c, playlist_edit_screens.c, playlist_edit_screens.h, screen_stack.c]
2026-07-22 UI: cover art on song rows, except when browsing one album
    Every row in a song list now shows the track's cover art on the left,
    deduped per unique (artist, album) so a run of same-album tracks only
    costs one MPD fetch + decode. Skipped entirely when the list is scoped
    to a single album (docs/PLAN.md's Albums drill-down), since every row
    there would just repeat the same art.
    [list_screen.c, list_screen.h, music_screens.c]
2026-07-22 Fix song list dropping tracks not credited to the browsing artist
    rpod_mpd_list_songs() ANDed an artist constraint together with the
    album constraint, so a track's own Artist tag had to match the artist
    used to drill down to get there. That silently dropped real tracks on
    any album where per-track Artist varies (features, collaborations,
    compilations sharing one AlbumArtist) -- caught on a 4-track album
    where only 1 track's own Artist tag matched. The album name alone now
    identifies the song set; the artist constraint only applies when no
    album is given.
    Also enable MPD's auto_update in the dev config: a stale local
    database (552 of ~762 tracks indexed) independently made some albums
    look i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
2026-07-22 UI: album header with cover, title/artist, and Play/Shuffle
    Single-album song lists now show cover art, album title, and artist at
    the top, followed by Play (plays the album in order) and Shuffle
    (random order) buttons, above the track rows.
    Play/Shuffle join the input group before the song rows so the click
    wheel defaults to Play on entry instead of the first track. Their
    header (cover + title/artist) also scrolls back into view on focus,
    not just the button itself, when returning to them after scrolling
    into the song list.
    Adds rpod_mpd_play_songs()/rpod_mpd_play_songs_shuffled() to
    mpd_client, and splits rpod_list_screen_build() into
    create()/populate() steps so a caller can insert head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
2026-07-22 UI: playlist header with cover mosaic, name, and Play/Shuffle
    Stored playlists now show the same header the single-album view got,
    with a 2x2 mosaic of up to four distinct album covers in place of one
    album's cover, the playlist name, its track count, and Play/Shuffle
    above the rows. Play/Shuffle join the input group before the song rows,
    so the wheel lands on Play on entry, same as an album.
    Generalises build_album_header() into build_collection_header() (title +
    subtitle + cover tile) rather than duplicating it, and factors the cover
    rendering into build_header_cover(): one cover fills the tile (album),
    two-to-four lay out as a mosaic (playlist), fewer decoded covers cycle to
    fill all fou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
2026-07-22 Play whole album/playlist from tapped song; re-cue to first on end
    Selecting a song inside an album or playlist queued only that one URI,
    so playback stopped after it and Now Playing fell back to "unknown
    song / unknown artist". Now the whole collection is queued and playback
    starts at the tapped track (rpod_mpd_play_songs_from), so it carries on
    into the following songs.
    When the queue plays out, MPD (repeat off) stops and drops the current
    song. rpod_mpd_get_status_settled() detects this (STOP with a non-empty
    queue) and re-cues to the first track paused, so the collection doesn't
    loop and the first song stays shown. Both the status bar poll and the
    Now Playing screen's own timer use it,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
    [music_screens.c, now_playing.c, status_bar.c]
2026-07-22 UI: virtualize the flat Songs list for fast load + smooth scroll
    The whole-library Songs list built one widget subtree per row, so on a
    762-song library it took ~25 s to open (258 cover-art decodes run
    synchronously on the UI thread) and scrolled at 4-18 fps (moving and
    redrawing every one of the ~6000 widgets is O(row-count) per step).
    Rebuild that screen (build_virtual_song_list + the vsong_* helpers) around
    a fixed pool of ~4 plain-lv_obj rows, rebound to a sliding data window as
    you scroll (whole-row shift), so only a handful of widgets ever exist:
    build drops to ~15 ms and a scroll step to ~1.4 ms.
    Navigation can't lean on lv_group focus (there is no per-row widget to
    focus), so a sin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
    [music_screens.c]
2026-07-22 UI: status bar reads "Now Playing" on that screen; scroll long titles
    The persistent top bar mirrors the current track (title + visualizer)
    everywhere except the Now Playing screen, where it now just reads
    "Now Playing" with no bars -- that screen already shows the big title and
    a full visualizer, so repeating them up here was redundant.
    Off Now Playing, a title too wide for the bar now scrolls within a fixed
    width (SCROLL_CIRCULAR, same as Now Playing's own title) instead of
    truncating with dots or wrapping. A short title is sized to content so it
    hugs its text and the flex row centres the visualizer+title pair as a
    unit, with the bars right next to the title.
    now_playing.c signals the ba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
    [now_playing.c, status_bar.c, status_bar.h]
2026-07-22 Like songs and add them to playlists from Now Playing and song lists
    Adds a "loved" heart to Now Playing and a per-song Add-to-Playlist flow:
    - Now Playing: a heart below the title/artist/album. Double-press centre
    toggles the track in "Liked Songs" (a default playlist, auto-created on
    first like) with a fill/pop animation; press-and-hold opens the picker.
    - Song lists (flat/album/artist/playlist): press-and-hold the selected
    song opens the picker. Play stays instant on a single press -- no
    double-tap-to-like on lists, so the primary action keeps zero latency.
    - Each song row shows a trailing mark: a filled heart when liked, a
    checkmark when it's in some other playlist (heart wins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
2026-07-23 Add ListenBrainz scrobbling with offline queue and crash recovery
    Submits "now playing" and "listen" events to ListenBrainz
    (api.listenbrainz.org) as MPD plays, via a new src/audio/listenbrainz.c
    (background-thread libcurl client, hand-rolled JSON, never blocks the LVGL
    tick) and src/audio/scrobbler.c (polls MPD status once a second, fires per
    the standard half-duration-or-4-minutes/30s-minimum submission rule). Wired
    into tools/sim/sim_main.c; no click-wheel text entry exists yet, so the
    user token comes from RPOD_LISTENBRAINZ_TOKEN (sim) / rpod.service's
    EnvironmentFile (device).
    rPod is portable, so "off Wi-Fi" is the normal state, not an occasional
    blip: "listen" events are durably queu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
2026-07-24 Add multi-board support and port the UI to the Waveshare 1.44" LCD HAT
    rPod was hardcoded to one config: a 320x240 ST7789V panel + click wheel,
    with screen size and fonts baked in as compile-time macros and the full UI
    running only in the simulator (src/main.c was still the Phase-1 stub).
    Introduce a runtime board abstraction selected by RPOD_BOARD and port the UI
    to the Waveshare 1.44" LCD HAT (128x128 ST7735S + 5-way joystick / KEY1-3) --
    the first hardware whose display and buttons both work, so it runs the real
    on-device UI, not the stub.
    - Board layer (src/platform/): a board bundles a display backend, an input
    backend, and a UI form factor. board_device.c registers `classic` (defau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
2026-07-24 Bring up the Waveshare 1.44" HAT display on panel-mipi-dbi (DRM)
    The HAT was running on the deprecated fbtft fb_st7735r driver, whose fixed
    GRAM (0,0) write window can't offset the 128x128 glass inside the ST7735S's
    132x162 memory -- the root cause of the wrong colours and the few-pixel
    garbage strip on two edges. Switch to the mainline panel-mipi-dbi DRM driver
    (docs/PLAN.md §5.1 preferred path), which takes explicit x/y offsets and
    handles SPI byte order correctly.
    Parameters pinned against the real panel with tools/fb-test's new grid/ruler
    modes:
    * x-offset=1, y-offset=2 (glass position in the 132x162 GRAM)
    * MADCTL 0x68 (MV|MX|BGR): upright, non-mirrored, correct RGB
    * native RG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
    [fb-test.c, lvgl_port.c]
2026-07-24 input: migrate HAT GPIO buttons to the libgpiod v2 API
    The device's libgpiod is v2, whose request-builder API replaces the v1
    gpiod_line_request_input_flags path used before. Each pin now gets its own
    single-line request (gpiod_chip_request_lines) so one failed pin can't sink
    the rest, and reads go through gpiod_line_request_get_value.
    Not yet built/exercised on hardware -- the on-device rpod rebuild is blocked
    (no aarch64 libmpdclient/libcurl headers on the dev box), and the joystick/
    keys weren't tested during the display bring-up.
2026-07-24 UI: fix HAT black edges, drop perf overlay, densify the square profile
    Three on-device fixes for the Waveshare 1.44" HAT (128x128), all found by
    dumping /dev/fb1 and reproduced against the real panel:
    - Turn OFF LV_USE_PERF_MONITOR (both lv_conf.h). The "30 FPS 50% CPU" box was
    anchored bottom-right and covered a chunk of the tiny panel -- it's a
    profiling overlay, not something to ship on either board.
    - Make the list card's inset a metrics field (list_margin) instead of a
    hardcoded `screen_w - 16` / `-16` / `-8` in list_screen.c. That uniform 8px
    margin is a tasteful iOS-style card at 320x240 but ~13% of a 128px panel,
    showing as the black strip on the right/bottom the user rep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
    [list_screen.c, metrics.c, metrics.h]
2026-07-24 UI: fix HAT rendering by flushing whole frames in one write
    The Waveshare 1.44" HAT (panel-mipi-dbi on kernel 6.18's drm_fbdev_dma
    + deferred I/O) only pushes a frame to the glass for LARGE fbdev writes.
    LVGL's stock fbdev flush writes one row per pwrite() (128*2 = 256 bytes
    here), and those tiny per-row writes never trigger the driver's damage
    flush -- so frames landed in the shadow buffer but never reached the
    panel. Symptoms: blank on boot except the status bar (its 1 Hz clock was
    the only thing changing often enough to coincide with a flush) and
    residue from previous screens.
    Root cause isolated on hardware via the SPI master's bytes_tx counter:
    a single >=16 KB write always presents; 1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
    [lvgl_port.c]
2026-07-27 UI: turn the playlist picker into a floating glass overlay
    Add rpod_screen_stack_open_overlay()/close_overlay() so a popup can float
    on LVGL's top layer over the still-rendering screen behind it, instead of
    being pushed as its own full screen. The "Add to Playlist" picker is the
    first user: a translucent glass sheet, dimmed backdrop, Menu closes the
    overlay before falling back to a normal pop (app.c's on_menu).
    Fix two bugs in the new picker sheet: lv_obj_remove_style_all() on the row
    list was also stripping lv_list's internal flex-column layout, so rows
    (Liked Songs, playlists) rendered stacked on top of each other instead of
    in order -- replaced with targeted overrides that only kill the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
    [app.c, list_screen.c, music_screens.c, now_playing.c, playlist_picker.c, playlist_picker.h, screen_stack.c, screen_stack.h]
2026-09-30 Remove the Waveshare 1.44" HAT
    The 1.44" LCD HAT was a stopgap side project -- hardware on hand while
    waiting for the real 2" ST7789V panel and click wheel -- not part of
    rPod, whose goal is a Pi inside an iPod with iPod hardware. Delete it and
    the multi-board machinery that existed only to support it.
    - Board layer: drop RPOD_BOARD, the board registry, and the form factor.
    rpod_board_t stays as the device-vs-simulator seam (display + input
    backends); src/platform/board_device.c is the one classic board.
    - UI: remove the 128x128 square profile and every square branch (Now
    Playing's compact layout, the Search / playlist-name keyboards, the
    collection header, status bar, playlist pick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
2026-09-30 Cross-build on the PC and bring up the Pi 3B dev board
    rpod.local is now a Raspberry Pi 3B breadboard dev board (Debian trixie)
    for bringing up the real hardware's wiring before the Zero 2 W build.
    Cross build: `make build` now uses clang + lld (host packages) against a
    sysroot copied off the Pi (`make sysroot`), so the binary links against
    the Pi's own glibc, libmpdclient and libcurl. A full build takes ~3 s on
    the PC versus many minutes natively on the Pi. The sysroot pull keeps only
    headers, GCC crt/libgcc bits and .so/.a/.o/.pc files (<= 8 MB each), and
    dereferences symlinks leaving the tree -- trixie's kernel headers ship
    asm/*.h as links into /usr/lib/linux/uapi. `SSH` is overridable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
2026-09-30 Bluetooth: BlueZ + system-wide PipeWire for MPD's Bluetooth output
    Phase 6 system side (docs/PLAN.md §6.3), staged ahead of Phase 5 and not
    yet run on hardware -- the Pi wasn't reachable when this was written.
    MPD is a system service with no user session, so PipeWire runs
    system-wide rather than per-user. Debian only packages the per-user
    units, so system/systemd/ carries upstream's own system-mode units
    (pipewire 1.4.2 / wireplumber 0.5.8, trixie's versions): a pipewire
    system user, sockets under /run/pipewire. mpd joins the pipewire group
    and the new "Bluetooth" output in mpd.conf points remote at
    /run/pipewire/pipewire-0 (off by default; Settings > Audio Output
    already toggles it).
    Wir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
2026-09-30 Click wheel: derive the bit map on hardware and wire it into the UI
    Phase 2 on the Pi 3B dev board, now that a replacement 4th-gen wheel is
    wired (CLOCK GPIO 23, DATA GPIO 25), plus the UI side of Phase 4's
    encoder indev.
    Bit map, from a guided wheel-sniff capture (249 packets, all well-formed;
    docs/clickwheel-protocol.md): buttons center/NEXT/PREV/PLAY/MENU on bits
    8-12, touch on 30, position on 16-22 with 96 positions per turn (0 at
    MENU, clockwise-increasing), preamble 0x1A in the low byte plus bit 31.
    That is the reference's constants plus one, as PLAN §4.3 predicted;
    its position read also dropped the low bit. The wheel sends packets
    only on change -- nothing repeats while a button is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
    [encoder.c, encoder.h, rpod-wheel.c, wheel-sniff.c, wheel-test-client.c, wheel_bits.h]
2026-09-30 Display: restore the 62.5 MHz SPI clock and flush whole frames at once
    Scrolling showed a slow wipe sweeping down the panel. Three causes, all
    measured on the Pi 3B dev board with the SPI controller's counters
    (/sys/bus/spi/devices/spi0.0/statistics):
    - The fbtft overlay line was 110 characters; the firmware truncates
    config.txt lines at 98, so `speed=62500000` was cut to `spe` ("Unknown
    dtparam 'spe' - ignored" in `vclog -m`) and the panel ran at the
    overlay's 32 MHz default. Split the params across dtparam= lines, and
    add fps=60 (16 ms deferred-I/O delay, was 32 ms) and txbuflen=32768
    (5 SPI transfers per frame instead of 38). A full frame now goes out in
    ~22 ms instead of ~40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
2026-09-30 UI: load cover art in the background, fetched in 1 MiB chunks
    Opening the Songs list froze the click wheel for many seconds. Not the
    song count (the library is 30 tracks) -- cover art. Measured on the Pi 3B
    against real FLAC rips with 1-3 MB embedded PNG covers:
    - Fetching one cover took 0.8-3.8 s: readpicture returns one binary chunk
    per round trip at MPD's default 8 KiB limit, 340+ round trips for a
    big cover. rpod_mpd_connect() now negotiates a 1 MiB "binarylimit"
    (falling back to 8 KiB on MPD < 0.22.4) and reads chunks straight into
    the output buffer: the same fetches take 12-43 ms.
    - Decoding one takes ~280 ms, and the song lists did fetch+decode inline
    on the LVGL thread for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
2026-09-30 Click wheel: prune hung-up clients so UI restarts can't fill the table
    rpod-wheel only dropped a disconnected client when a broadcast to it
    failed -- i.e. on the next wheel event. Restarting the UI a handful of
    times without touching the wheel (a deploy/test loop) filled all 8 slots
    with dead sockets, and the daemon then turned the live UI away ("client
    table full, dropping connection" once a second): a dead wheel. Before
    adding a client, peek each existing one; clients never send anything, so
    EOF means it hung up. Verified on the Pi: 12 connect/close cycles with no
    wheel input, then a new client is still accepted and rPod stays
    connected.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
    [rpod-wheel.c]
2026-10-01 Bluetooth: Settings > Bluetooth screen over BlueZ's D-Bus API
    Replaces the "Not available without hardware" placeholder, which never
    probed anything, with a real screen (docs/PLAN.md §6.3, §8.1): adapter
    power, paired devices (Connect/Disconnect, Forget), and Search for
    Devices, which lists nearby unpaired audio devices and runs pair -> trust
    -> connect on the one selected. Missing pieces are named rather than
    hidden: "The Bluetooth service isn't running", "No Bluetooth adapter
    found", "Blocked by rfkill".
    src/audio/bluetooth.c is a BlueZ client on sd-bus (libsystemd). It runs
    entirely on the LVGL thread: every call is async and an lv_timer drains
    the bus, so a multi-second Pair() never b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
    [app.c, bluetooth_screens.c, bluetooth_screens.h, settings_screens.c, settings_screens.h]
2026-10-04 Now Playing: wheel sets the volume, with an iOS-style HUD
    On Now Playing the wheel now turns the volume, clockwise louder, 4% a
    step: the iPod's own behaviour, replacing PLAN §8.2's "scrub". While it
    turns, a small capsule drops in over the status bar with a speaker glyph
    and a level bar, like the volume HUD iOS shows in landscape. It tucks
    itself away after 1.5 s idle.
    The HUD (src/ui/volume_hud.c) lives on LVGL's system layer, above the
    status bar. It slides down and widens out with an ease-out-back curve:
    LVGL's lv_anim_path_overshoot starts from rest, which left the pill
    invisible for the first ~130 ms of a turn. The fill slides between levels.
    Turning past 0 or 100 rubber-bands the pi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
2026-10-04 Bluetooth: use MPD's software volume curve, headset pinned at 75%
    Bluetooth volume ran the wrong range: the bottom of the wheel was silent
    and the top wasn't loud. Two attenuations were stacking up, both measured
    on the Pi.
    MPD's pipewire mixer maps volume to a cubic stream gain (50% = -18 dB,
    4% = -84 dB), which wastes the wheel's bottom quarter. The Bluetooth output
    now uses mixer_type "software", like Headphones and the planned DAC.
    MPD's curve is ~1.5 dB per 4% step, with 4% at -50 dB.
    WirePlumber runs stateless here, so every connect put the headset at its
    default-sink-volume of 0.064. PipeWire sends cbrt(volume) as the AVRCP
    absolute volume, so that's 40% of the headset's own scale,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
2026-10-04 Volume: remember the level per Bluetooth device
    Like a phone, rPod now keeps a volume per output: AirPods come back at the
    AirPods' level, a speaker at the speaker's, and the wired output (no
    Bluetooth audio device connected) at its own.
    src/audio/volume_memory.c keys levels by device address, plus "wired",
    and persists them to /var/lib/rpod/volumes (RPOD_VOLUME_STATE; the sim
    uses ~/.local/state/rpod-sim/volumes). The file is written via temp and
    rename, once a level settles. Levels are MPD's software volume, read once
    a second, so a change from anywhere is captured, not just from the wheel.
    It follows the Bluetooth module's device mirror through a process-lifetime
    watcher; rpod_bt_watch(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
2026-10-05 Fonts: add curly quotes and the ellipsis
    iOS names AirPods "Name’s AirPods Pro" with a right single quotation
    mark (U+2019), and the fonts stopped at Latin Extended-A, so the name
    rendered as a missing-glyph box in Settings > Bluetooth. Curly quotes in
    song tags ("Don’t Stop Me Now") had the same problem.
    Regenerated the four sizes (14/16/20/24) with lv_font_conv 1.5.3 and the
    same options, plus U+2018-U+201D and U+2026. Montserrat has six of those
    (‘ ’ ‚ “ ” …). The post-processing matches 883feb5: a plain
    #include "lvgl.h" and no LV_FONT_MONTSERRAT_* guard. Every existing
    glyph's bitmap is byte-for-byte unchanged; the rest of the diff is the
    new glyphs and the indices afte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
2026-10-05 AirPods: battery, noise control and settings over Apple's protocol
    AirPods speak Apple's accessory protocol (AAP) on a second L2CAP channel,
    PSM 0x1001, beside A2DP. It carries per-bud and case battery, in-ear
    state, noise control, Conversation Awareness, stem presses and the
    AirPods' own settings. This is the LibrePods spike from PLAN.md §6.3.
    LibrePods' Linux app is a desktop tray app that drives media through
    MPRIS and PulseAudio on a session bus, which the Pi doesn't have, and
    it's GPL-3.0. So the protocol is reimplemented in C from LibrePods'
    notes; none of its code is included.
    src/audio/aap.c encodes and decodes packets, with no I/O.
    tests/test_aap.c checks it against the real AirPo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
    [airpods_screens.c, airpods_screens.h, app.c]
2026-10-05 AirPods: saved pairings, reconnect, battery card, swipe volume, HUD
    AirPods needed pairing mode every time because no pairing was ever kept.
    rPod paired without a BlueZ agent, and with none registered and
    AlwaysPairable = false (BlueZ's default) the adapter is non-bondable. The
    kernel then pairs with "no bonding" and drops the link key at disconnect:
    the Pi showed the AirPods as Paired: yes, Bonded: no. bluetooth.c now
    exports a NoInputNoOutput agent and registers it whenever bluetoothd
    appears, claiming the default agent on the device (the sim leaves the
    desktop's alone unless RPOD_BT_DEFAULT_AGENT=1). It refuses code
    requests, and only confirms pairings or authorizes untrusted devices
    whil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
2026-10-05 Input: hold gestures, silent scan, sleep, and the alphabet scrub
    Finishes the input side of Phase 4 (docs/PLAN.md §8.2).
    Both backends (the click wheel client and the sim's keyboard) now feed
    one rpod_input_t (src/input/input.c) with raw button edges and
    rotation, and src/input/gestures.c sorts taps from holds for both: Menu
    acts on press; Play/Pause and Next/Prev act on release, so a hold can't
    also fire the tap. Play/Pause held 1.5 s pauses and sleeps. Next/Prev
    held 0.5 s scans. Prev restarts the song, or goes back one within its
    first 2 s. Menu at the root does nothing, so mashing it to back out of
    a deep menu can't sleep the device. The gesture logic is pure and
    covered by tests/test_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
2026-10-05 Covers: read FLAC art directly, cache it on disk, and stop blocking MPD
    Covers took 2-3 s to appear and songs were slow to start. Measured on
    the Pi 3B during a big rsync onto the card: each cover cost 60-700 ms
    to fetch over MPD plus ~250 ms to decode, one at a time, never kept
    across restarts. Worse, MPD serves readpicture on its main thread,
    re-reading the file for every chunk, so while a cover was fetched every
    other client waited: the UI's status poll, normally 0.2 ms, averaged
    69 ms and peaked at 1.4 s. Now Playing fetched and decoded its art
    twice inline on the LVGL thread, a 0.6-1.2 s freeze on every push and
    track change.
    Covers are now read straight out of the FLAC's PICTURE block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
2026-10-05 Click wheel: keep memory compaction off pigpio's DMA control blocks
    The wheel went silent during a big rsync onto the Pi 3B: the daemon was
    up and the UI connected, but wheel-test-client saw no events at all.
    pigpio's sampler had stopped. Its DMA control blocks live in mlock'd
    user pages (PI_MEM_ALLOC_PAGEMAP, since vc4-kms-v3d breaks the mailbox
    allocator), and memory compaction may migrate locked pages unless
    vm.compact_unevictable_allowed is 0. With RAM full of page cache,
    kcompactd had migrated 572k pages since boot; one batch took pigpio's
    blocks, leaving DMA channel 14 on a garbage control block (invalid
    src/dst, DREQ_STOPS_DMA) and sampling nothing, with no error anywhere.
    rpod-wheel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
2026-10-05 Display: rotate in software so scrolling stops tearing diagonally
    Scrolling a menu showed a diagonal jitter on every frame. The ST7789V
    refreshes its glass one native (portrait) row at a time, and fbtft's
    rotate=90 sets MADCTL MV|MY, which turns each landscape row it sends
    into a native column: every push swept the glass at right angles to the
    refresh, so any refresh pass overlapping a push showed new pixels on one
    side of a slanted line and old ones on the other. The Waveshare module
    doesn't break out the panel's TE line, so there's nothing to sync to.
    fbtft now runs at rotate=0 (a native 240x320 framebuffer), and
    src/ui/lvgl_port.c renders the 320x240 UI in DIRECT mode and rotates
    each re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
    [lvgl_port.c]
2026-10-05 Covers: progressive JPEG, palette PNG, and art from any track
    Six albums in the library showed no cover. Two were progressive JPEGs,
    which TJpgDec (vendored with LVGL) can't read by design, and one was a
    palette PNG, which the PNG decoder didn't handle. The other three did
    have art, just not on the track the cache reads: their first track has
    no embedded picture, but track 2 or 4 does.
    JPEG now goes through the system's libjpeg-turbo instead of TJpgDec. It
    reads progressive files too, and scales in the DCT (1/2, 1/4, 1/8), so a
    big cover is only ever decoded down to about twice the tile's size, with
    the area-averaging resampler doing the rest. Errors come back through
    longjmp(), so the deco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
    [cover_art.c, cover_art.h, cover_cache.c]
2026-10-05 Settings: a backlight timer and a sleep timer
    Backlight and Sleep Timer were placeholder screens. Both are now live
    lists of choices with the current one checked, like the AirPods pickers.
    Backlight turns the screen off after 10 s to 2 min without input, or
    never; 30 s by default, kept in /var/lib/rpod/backlight. Going dark is
    sleep's own path (now go_dark() in app.c): black curtain, rendering
    stopped, bl_power off. But it's a lighter, "dim" sleep in the gesture
    layer. Touching or turning the wheel wakes it, and the turn that woke it
    doesn't move the selection. Center and Menu only wake it, so nothing is
    selected unseen. Play/Pause, Next and Prev wake it and act, as an iPod's
    do in a pocket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
    [app.c, app.h, backlight.c, backlight.h, gestures.c, gestures.h, input.c, input.h]
2026-10-15 Settings: drop the explanatory notes under menu titles
    Theme, Backlight, Sleep Timer and the AirPods pickers each carried a line
    restating what the screen does. Only text that tells you something live
    stays: the sleep countdown, connection and battery state, unsaved-pairing
    warnings, the pairing-mode hint before any device shows up, and Press and
    Hold's "Choose at least two." Row subtitles go too where the row's name
    already says it (Conversation Awareness, Automatic Ear Detection).
2026-10-15 Classic: the liked heart in Now Playing's corner and the picker's marks
    Now Playing's heart moves from the header's middle slot to its right
    corner, 5 px in like "3 of 12" on the left; the repeat and shuffle icons
    step 9 px left while it shows. The playlist picker's Liked Songs row
    uses the iPod-style pixel heart, shown only while the song is liked,
    like the checks on the other rows -- not glass's heart control
    recoloured, so rpod_heart_set_color() goes.
2026-10-15 AirPods: photos and MingCute's glyph in Glass, pixel art in Classic
    The AirPods pictures were drawn procedurally, and looked it. Glass's
    battery card now shows photos from Wikimedia Commons: AirPods Pro by
    Burkhard Mücke (CC BY-SA 4.0, which the cut-out keeps) and their case by
    Jackienyyy (CC0). The status bar and HUD glyph is MingCute's airpods-fill
    (Apache-2.0), the clearest at 12 px of the open icon sets tried.
    tools/airpods-art.py downloads the photos (pinned by Commons' SHA-1s),
    cuts them out with GrabCut, greys them and scales them down in linear
    light into src/ui/airpods_art_data.c. Its output is reproducible byte
    for byte. Credits are in that file's header and the README.
    The class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
2026-10-15 Extras: Clock with an alarm, Brick, Music Quiz and Screen Lock
    Extras was a placeholder; it now holds the 4th-gen iPod's own (less the
    organiser and the imports) plus the later iPods' Screen Lock, in all
    three themes (docs/PLAN.md §8.5):
    - Clock: the time and date in big numerals -- the iPod's clock digits in
    Classic, a 64 px Montserrat in Glass -- over Alarm Clock and Sleep
    Timer. The alarm plays Shuffle Songs or a playlist, fading in from a
    tenth of the volume over ~30 s as a volume-memory duck stepped back up,
    wakes the screen from either sleep, and offers Snooze (9 min) or Stop
    on a card; Menu leaves the music playing. Its time is set the iPod's
    way, a field at a time with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
2026-10-15 Web UI: uploads, the library and advanced settings, in the device's theme
    rpod-web serves a web UI from the device at http://rpod.local/
    (docs/PLAN.md §8.6), dressed in whatever theme rPod has and following it
    live: Glass with real backdrop blur over the cover art, or the iPod at
    2x -- its title bar and rule, rows of Chicago with the selection
    inverted, its arrow, scrollbar and rounded sliders. Screens drill down
    like the device's menus, and the keyboard drives them like the wheel.
    - Upload Music: songs or whole album folders, dropped anywhere or
    picked, into the folder in view, two at a time with progress. Names
    are made exFAT-safe, non-music is left out, existing files are kept
    unl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
2026-10-16 Docs: defer the wired DAC and the USB gadget
    Audio is Bluetooth and music arrives through the web UI, so Phases 3 and 5
    move to a Deferred section in the plan; the specs stay for later.
2026-10-16 Docs: a Pi Zero 2 W wiring diagram for the display and the click wheel
    docs/wiring-zero2w.svg draws the Zero 2 W from above with a wire from
    each header pin to the Waveshare 2" module's connector and to an 8-pin
    FPC breakout for the wheel's ribbon, each labelled with its Pi pin and
    GPIO. The README shows it; docs/wiring.md adds a table per part. The
    ribbon's pin numbers (3 and 7 tied to power, 4 and 5 unconnected) are
    from Jason Garr's notes on the same 4th-gen wheel.
    tools/wiring-diagram.py generates it, with the pin choices as tables at
    its top, so a pin change is a re-run rather than a hand edit.
2026-10-16 Videos: upload in the web UI, converted to fit, played on the device
    Main Menu > Videos (docs/PLAN.md §8.7), as on the iPod with video: a
    video uploaded from the web UI plays full screen, its sound through MPD
    to the headphones or Bluetooth.
    - Conversion, the iPod's way: rpod-convert (web/rpod_convert.c, C on the
    FFmpeg libraries MPD already brings) makes every upload one plain kind
    -- fitted to 320x240 with a phone's rotation applied, 30 fps at most,
    H.264 Main and stereo AAC in an MP4 with its index first, a silent
    track if it had none -- plus a poster frame. rpod-web runs it one at a
    time (web/videos.c) under the idle CPU and I/O scheduler, with an OOM
    score of 1000 so a sou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
2026-10-17 Setup: make pi-setup for a fresh Pi, and the Zero 2 W as rpod.local
    rpod.local is now the Pi Zero 2 W that goes in the iPod, with the display
    and the click wheel wired to it. The 3B dev board's setup was done by hand;
    this one is a script, run end to end on the fresh install.
    - system/setup.sh (`make pi-setup`) sets up a fresh Raspberry Pi OS Lite
    64-bit: PLAN §3's packages, pigpio from source into /usr/local, the
    boot config fragment between markers at the end of config.txt (a re-run
    replaces it), fbcon=map:9 quiet logo.nologo, the panel's overlay, the
    boot-time units off, mpd.socket masked, /media/music and /media/videos,
    /etc/rpod/env, then bluetooth/setup.sh. It runs as a sys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
2026-10-17 Power: the PiSugar 2's battery and RTC, Shut Down and Auto-Off
    A PiSugar 2 under the Zero 2 W is its battery now: an IP5209 power bank
    chip at I2C 0x75 and an SD3078 RTC at 0x32 (PLAN §7.6). rPod reads the
    first itself; PiSugar's own server isn't installed.
    - src/power/battery.c reads the IP5209 every 2 s on a thread of its own
    (rpod joins the i2c group). gauge.c turns that into a level: the chip
    keeps no charge count, and its current register is what the Pi draws,
    not the cell's current (it reads the same with USB in), so the level is
    the voltage through PiSugar's curve, averaged over 30 s and stepping
    only one way per power source. USB power is register 0x78, found by
    pluggin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
2026-10-17 Docs: an rPod logo, and the README caught up
    - docs/logo/: a monoline wordmark whose o is the click wheel, its centre
    button in Glass's accent (#0a84ff), on dark and on light, and a square
    mark of that wheel on a Glass tile for icons. Every letter is a path,
    so the SVGs need no font.
    - README: the wordmark at the top, light or dark with GitHub's theme. The
    intro drops "lossless": Bluetooth is lossy, so the headphones get a
    re-encoded copy whatever the file, and Phase 6 now says so. Status
    follows the last commits: make pi-setup, the PiSugar 2's battery, Shut
    Down and Auto-Off under Phase 5 with what's left of it, the AirPods
    checks marked as done on the 3B, and no "~830 track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
2026-10-17 Boot: the rPod logo at ~10 s, the menu at ~22 s
    On the Zero 2 W, from power-on, the panel used to stay black until fbtft
    loaded at ~21 s and the menu came up at ~48 s. Now the logo is up at
    ~10 s, while the Pi boots behind it, and the menu at ~22 s (PLAN §3).
    - The logo: daemon/rpod-splash.c, run by rpod-splash.service as
    userspace starts. The unit loads the panel's driver itself instead of
    waiting for udev's coldplug; the program draws the wordmark from its
    geometry (dark, or light for Classic) the moment fbtft's framebuffer
    appears, and pushes it like rpod does. rpod.service is ordered after
    it, and it's RemainAfterExit so later unit starts can't run it again
    over the UI.
    - F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
2026-10-17 Home Assistant: Extras app to control lights, locks and climate from the wheel
    REST client on a worker thread (src/ha), Extras > Home Assistant screens,
    address and token set from the web UI, tools/fake-ha.py for testing.
2026-10-17 Backlight: switch it on as rPod starts
    rPod only switched the backlight on when it woke. Restarted while the
    last instance had gone dark (idle, or asleep), it came up with the
    backlight still off but believing itself awake: a black screen, and no
    button could wake it, since nothing was asleep. It now switches it on
    as soon as the display exists.
2026-10-17 AirPlay: play on HomePods and Apple TVs through OwnTone, from Play On
    Holding Play/Pause for 0.7 s on Now Playing opens Play On, a glass popup
    like Add to Playlist (both now build on screens/sheet.c): the connected
    headset and the AirPlay speakers on the network, the current one
    checked. Settings > Audio Output is gone, on the device and the web UI.
    AirPlay is OwnTone (system/owntone/, `make owntone-setup`, part of
    pi-setup), from its own apt archive for Raspberry Pi OS, speaking
    AirPlay 2. PipeWire's AirPlay 1 sink was tried first: the HomePod mini
    on audioOS 27 answered it 403 Forbidden. OwnTone isn't a second music
    server: MPD's new "AirPlay feed" fifo output is the only thing in its
    lib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
2026-10-17 Volume: lower the Bluetooth and AirPlay ceilings 15 dB, halve the wheel step
    Normal listening sat at the wheel's bottom 20-30% and the lowest click
    wasn't quiet.
